AfuJugendFdb/BrainTrainer/readme.md

BrainTrainer
----------------

Bausatz Ferienprogramm 2016
Simon Says mit 4 LEDs, die in zufälliger Reihenfolge aufleuchten und deren Abfolge mit den entsprechenden 4 Tastern reproduziert werden müssen.
Jetzt mit fancy Correct-, Fail- und LevelUp-Sounds
