AfuJugendFdb/BrainTrainer/Doku/Bestellliste_Reichelt.jpg

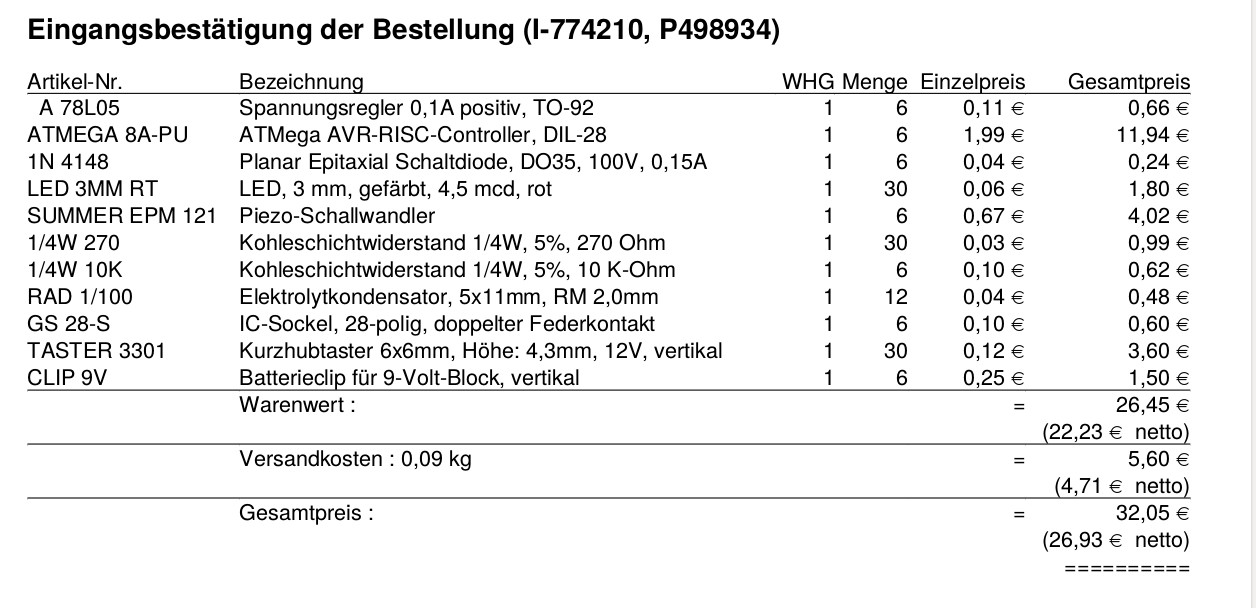
Doku/Bestellliste_Reichelt.jpg
