AfuJugendFdb/BrainTrainer/Hardware/BrainTrainer/BrainTrainer.png

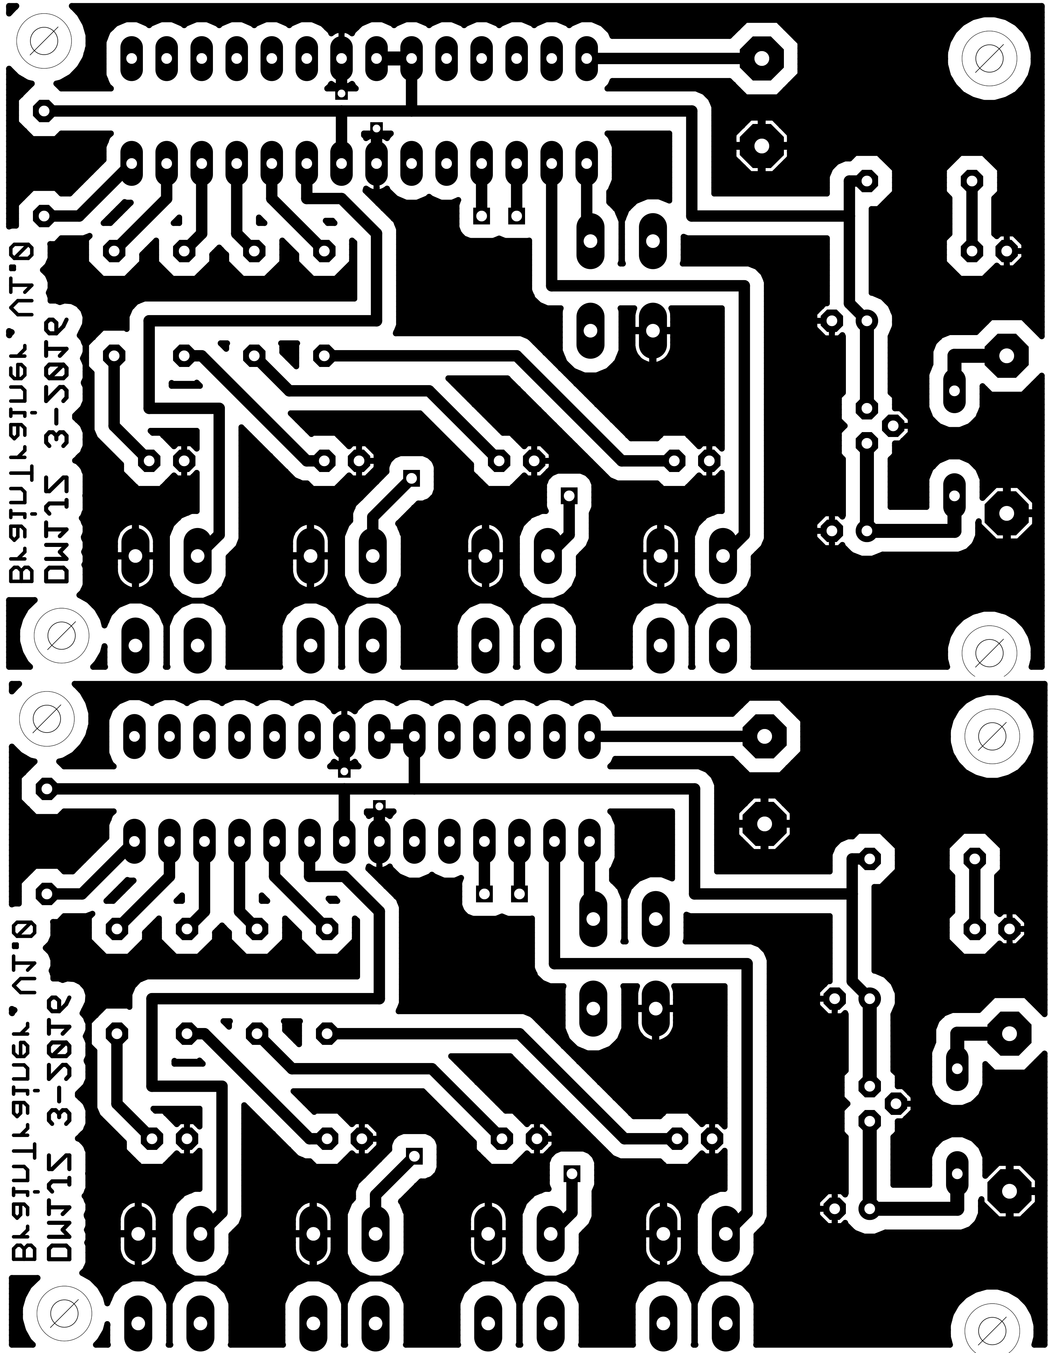
Hardware/BrainTrainer/BrainTrainer.png
