AfuJugendFdb/BrainTrainer/Hardware/BrainTrainer/Layout_doku.png

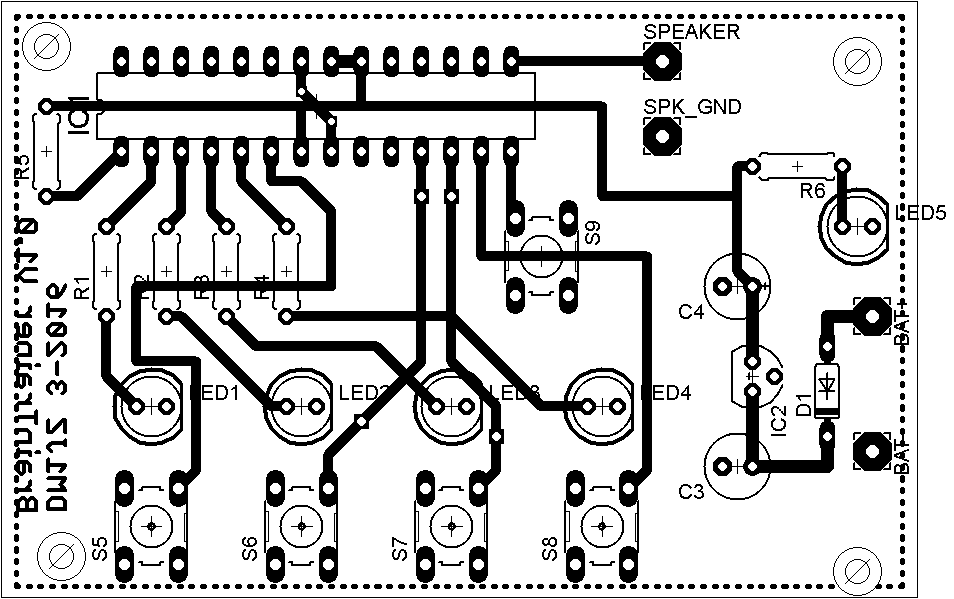
Hardware/BrainTrainer/Layout_doku.png
