AfuJugendFdb/BrainTrainer/Hardware/BrainTrainer/Schaltplan_doku.png

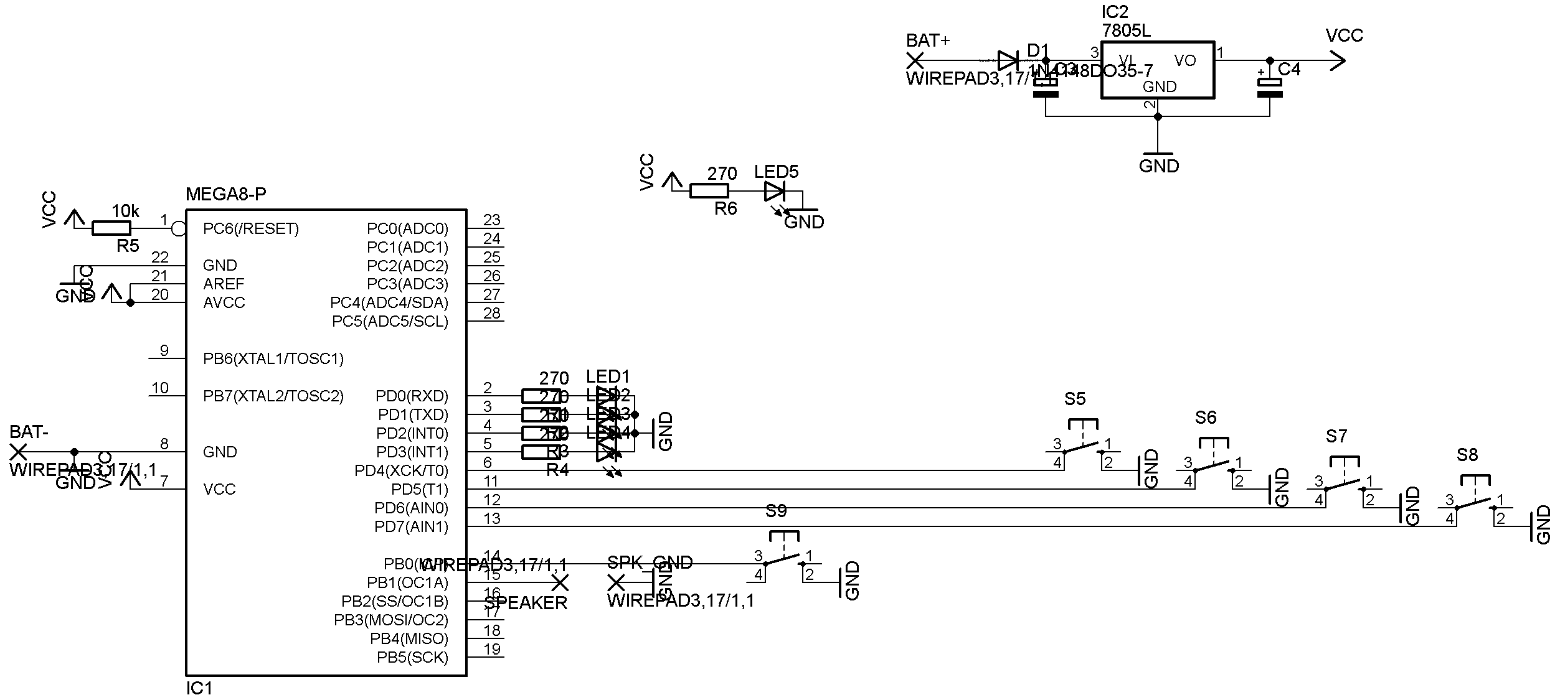
Hardware/BrainTrainer/Schaltplan_doku.png
