AfuJugendFdb/BrainTrainer/Hardware/BrainTrainer/BrainTrainer.pdf

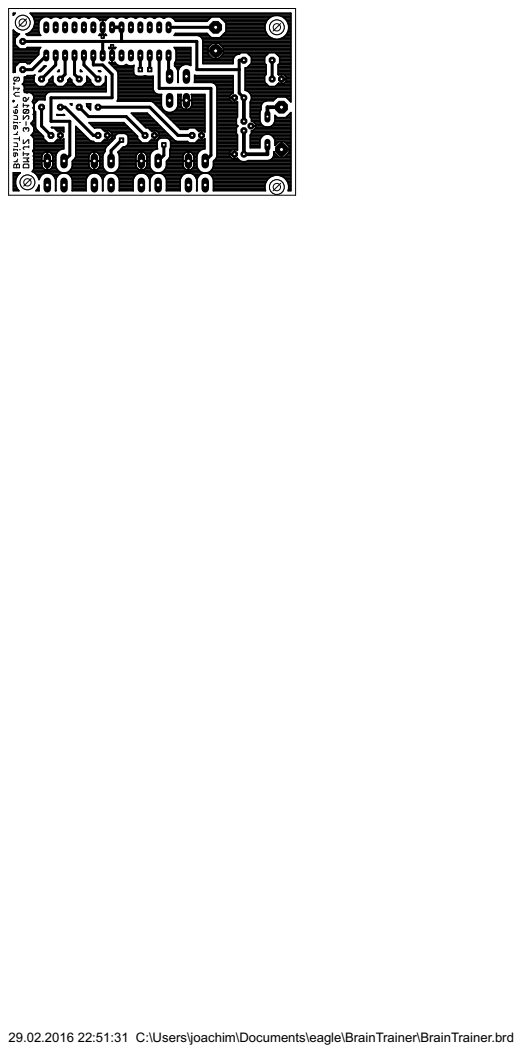
[picture p5: page 1]

29.02.2016 22:51:31 C:\Users\joachim\Documents\eagle\BrainTrainer\BrainTrainer.brd
