AfuJugendFdb/BrainTrainer/Hardware/BrainTrainer/BrainTrainer.brd

## EAGLE design Hardware/BrainTrainer/BrainTrainer.brd (2017-03-11)

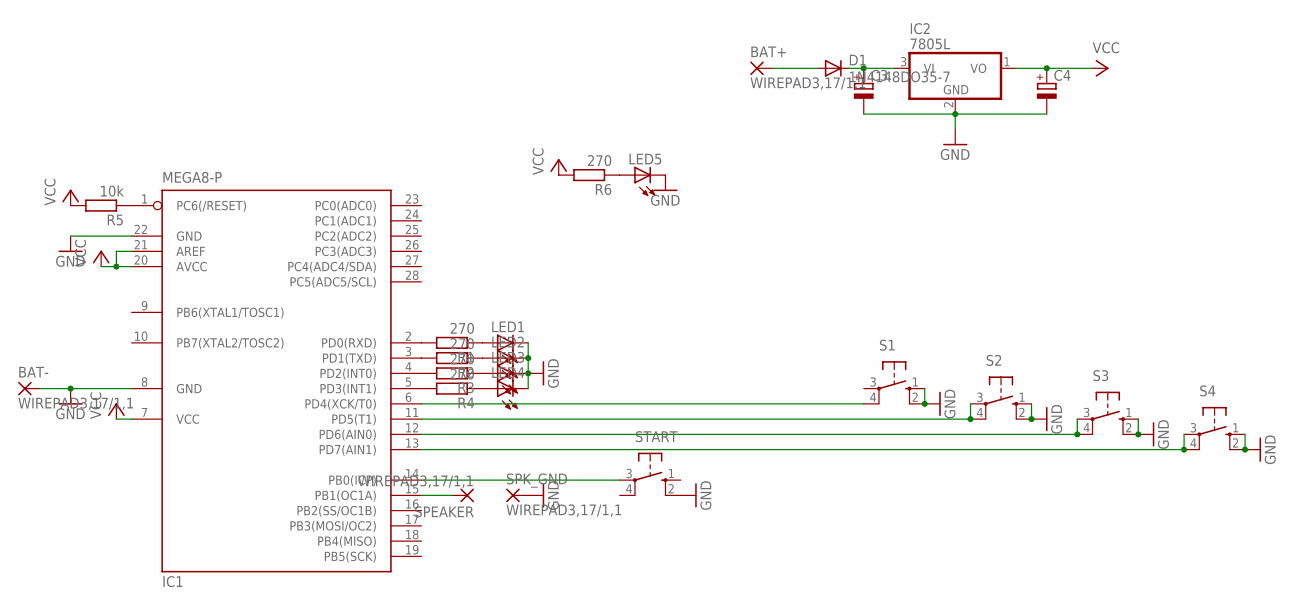
[picture p6: schematic BrainTrainer.sch]

Parts:
BAT+: WIREPAD3,17/1,1; 3,17/1,1
BAT-: WIREPAD3,17/1,1; 3,17/1,1
C3, C4: CPOL-EUE2,5-6E; E2,5-6E
D1: 1N4148DO35-7; DO35-7
IC1: MEGA8-P; DIL28-3
IC2: 7805L; TO92
LED1, LED2, LED3, LED4, LED5: LED5MM
R1, R2, R3, R4, R6: 270; 0207/7
R5: 10k; 0207/7
S1, S2, S3, S4: 10-XX; B3F-10XX
SPEAKER: WIREPAD3,17/1,1; 3,17/1,1
SPK_GND: WIREPAD3,17/1,1; 3,17/1,1
START: 10-XX; B3F-10XX

Connections:
GND: BAT-.1, C3.-, C4.-, IC1.8 (GND), IC1.22 (GND), IC2.2 (GND), LED1.K (C), LED2.K (C), LED3.K (C), LED4.K (C), LED5.K (C), S1.1 (S), S1.2 (S1), S2.1 (S), S2.2 (S1), S3.1 (S), S3.2 (S1), S4.1 (S), S4.2 (S1), SPK_GND.1, START.2 (S1)
unnamed: IC1.15 (PB1(OC1A)), SPEAKER.1
unnamed: IC1.2 (PD0(RXD)), R1.2
unnamed: LED1.A, R1.1
unnamed: IC1.3 (PD1(TXD)), R2.2
unnamed: LED2.A, R2.1
unnamed: IC1.4 (PD2(INT0)), R3.2
unnamed: LED3.A, R3.1
unnamed: IC1.5 (PD3(INT1)), R4.2
unnamed: IC1.6 (PD4(XCK/T0)), S1.4 (P1)
unnamed: IC1.11 (PD5(T1)), S2.3, S2.4 (P1)
unnamed: IC1.12 (PD6(AIN0)), S3.3, S3.4 (P1)
unnamed: IC1.13 (PD7(AIN1)), S4.3, S4.4 (P1)
unnamed: BAT+.1, D1.A
unnamed: IC1.14 (PB0(ICP)), START.3
unnamed: LED4.A, R4.1
unnamed: C3.+, D1.C, IC2.3 (VI)
unnamed: IC1.1 (PC6(/RESET)), R5.1
unnamed: LED5.A, R6.1
VCC: C4.+, IC1.7 (VCC), IC1.20 (AVCC), IC1.21 (AREF), IC2.1 (VO), R5.2, R6.2

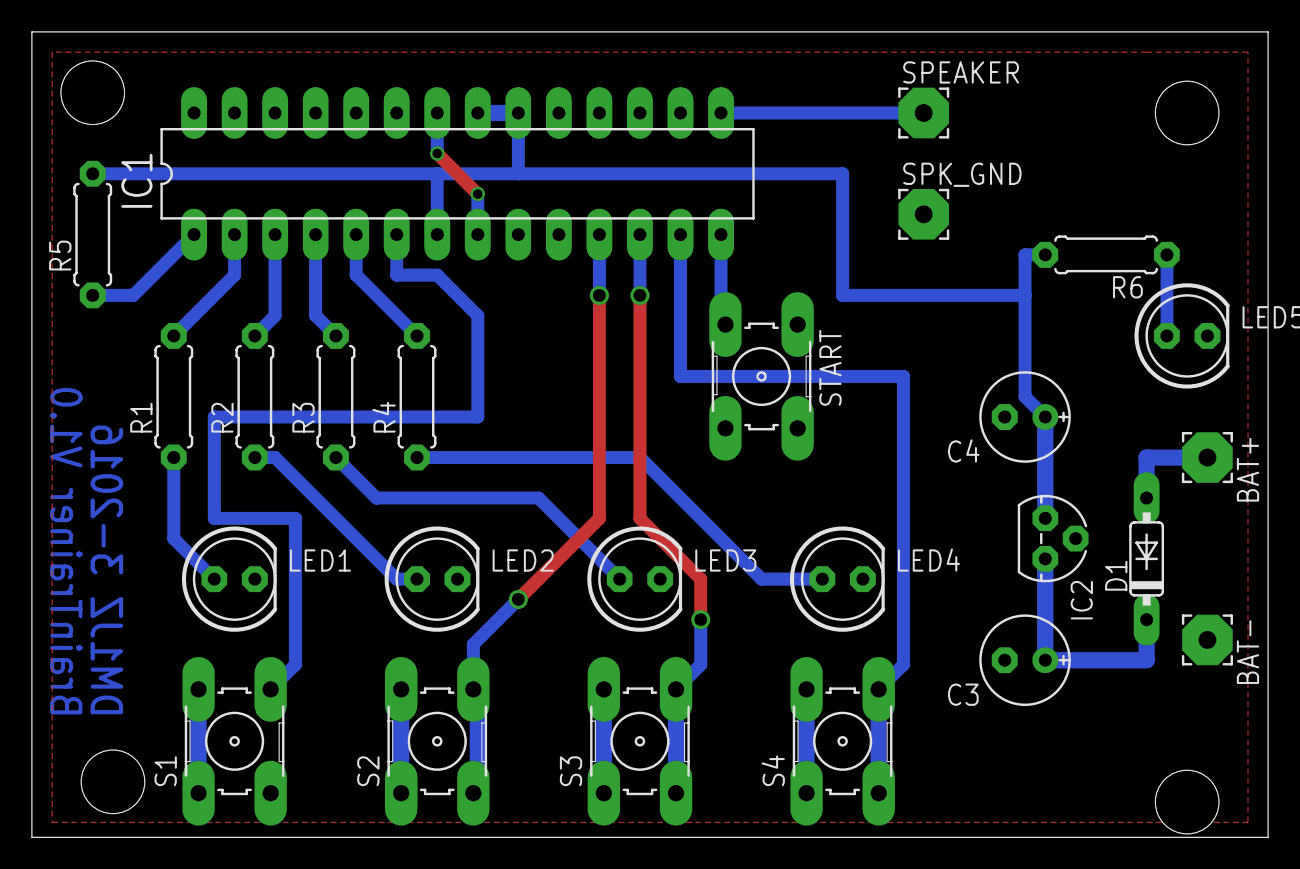
[picture p7: board BrainTrainer.brd from above]

Board: 2 copper layers, 77.5 x 50.5 mm, 25 parts (0 on the bottom side), 20 nets.
